saadafzal24/PAB-Project/Transducer Fabrication Files/Transducer_Base_Single_Ring_For_Printing.SLDPRT

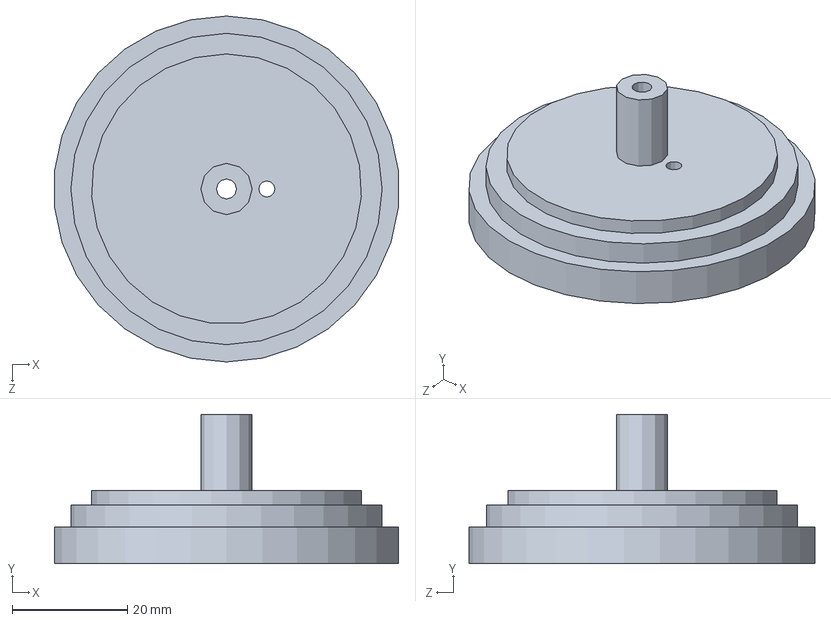
[picture p1: CAD file, 2020-03-28]
Transducer Fabrication Files/Transducer_Base_Single_Ring_For_Printing.SLDPRT
59.7 x 25.9 x 60.0 mm
