saadafzal24/PAB-Project/Transducer Fabrication Files/Mold_mod.SLDPRT

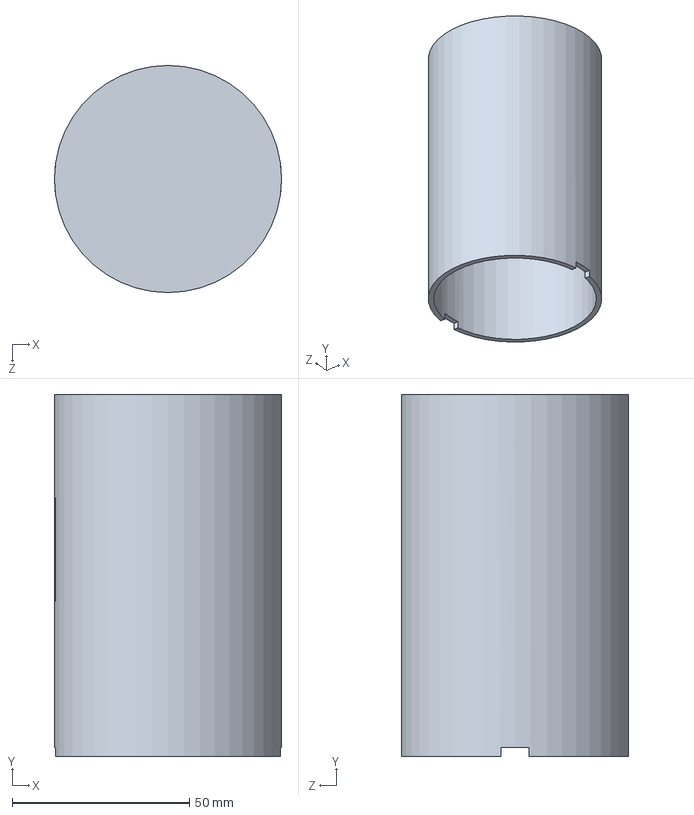
[picture p2: CAD file, 2020-03-28]
Transducer Fabrication Files/Mold_mod.SLDPRT
64.0 x 102.0 x 64.0 mm
