saadafzal24/PAB-Project/Transducer Fabrication Files/Transducer_Cap (1).SLDPRT

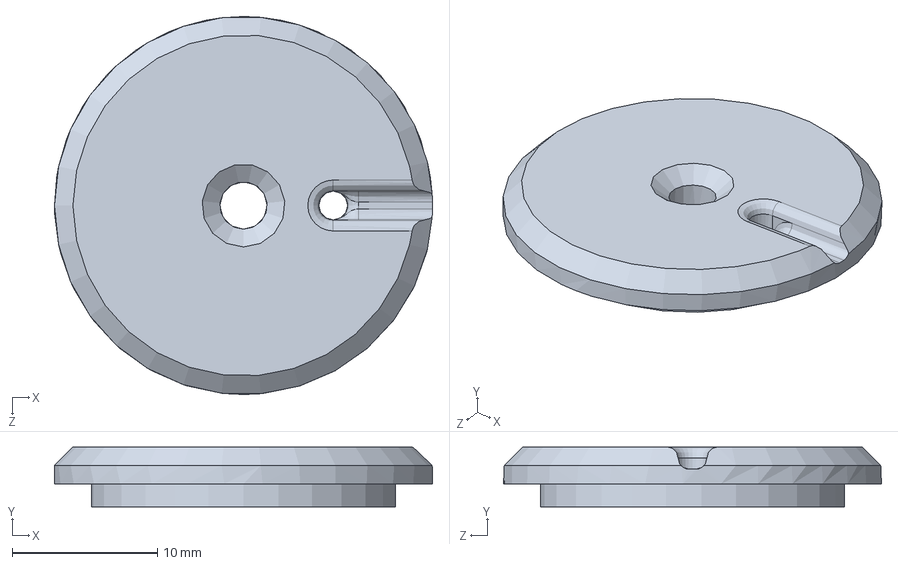
[picture p3: CAD file, 2020-03-28]
Transducer Fabrication Files/Transducer_Cap (1).SLDPRT
26.0 x 4.13 x 26.0 mm
