saadafzal24/PAB-Project/Transducer Fabrication Files/Washer.SLDPRT

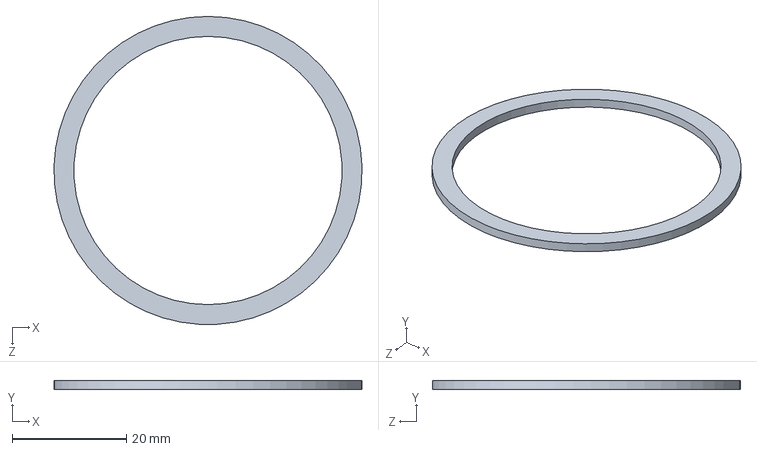
[picture p4: CAD file, 2020-03-28]
Transducer Fabrication Files/Washer.SLDPRT
54.0 x 1.59 x 54.0 mm
